speckmanj/ve_emc_pipeline/cad/out/markers_letter.pdf

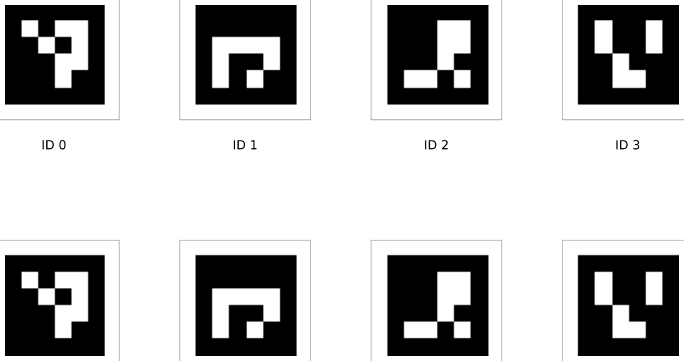
[picture p1: figure]

ID 0 | ID 1 | ID 2 | ID 3

50 mm: measure this before cutting (print at 100%)

Valence EMC scanner plate markers - ArUco 4x4, IDs 0-3. Cut on the gray line. Glue-stick into the pockets: ID 0 front-left (1 dimple), ID 1 front-right (2),
ID 2 back-right (3), ID 3 back-left (4). Label rotation does not matter.
