speckmanj/ve_emc_pipeline/cad/out/markers_letter.png

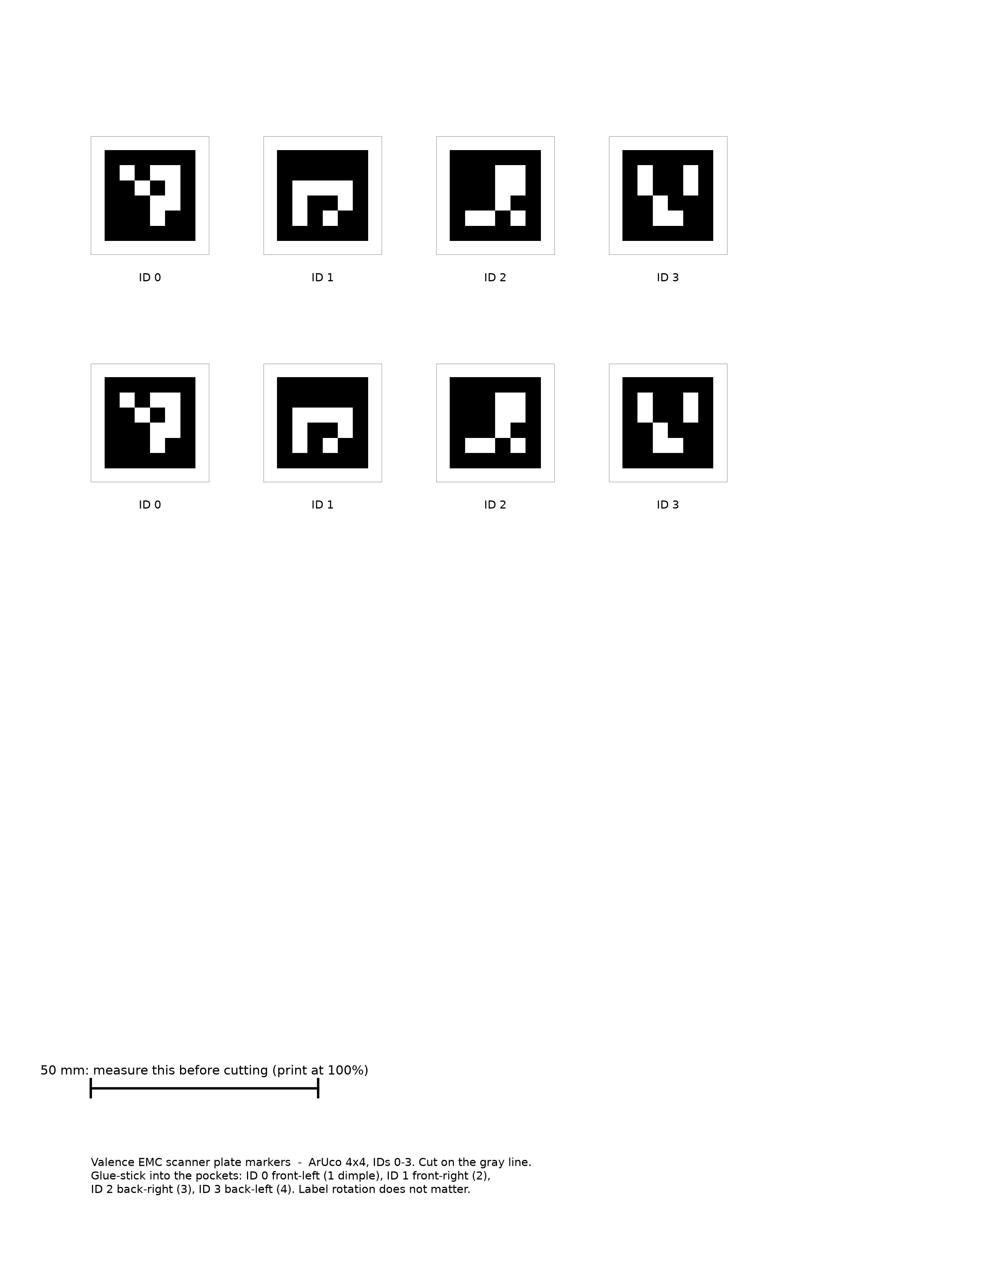
cad/out/markers_letter.png
