speckmanj/ve_emc_pipeline/cad/out/spacer_plate.stl

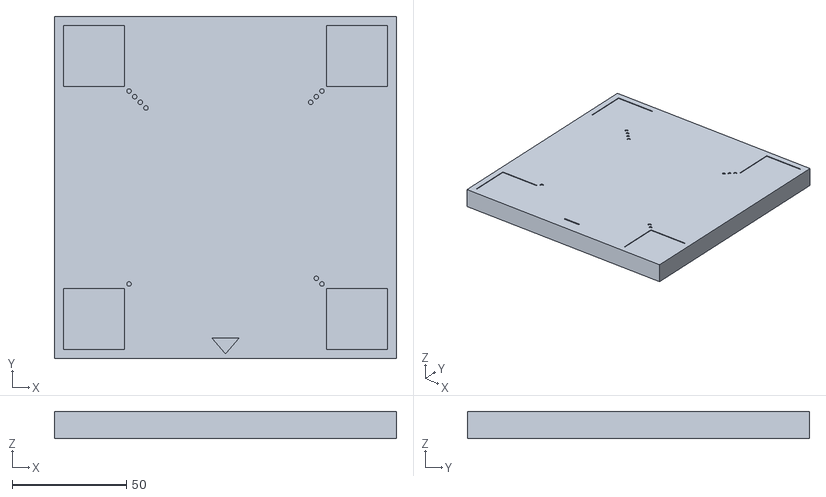
[picture p3: CAD file, 2026-11-12]
cad/out/spacer_plate.stl
150.0 x 150.0 x 12.0
