speckmanj/ve_emc_pipeline/cad/out/probe_mount_y.stl

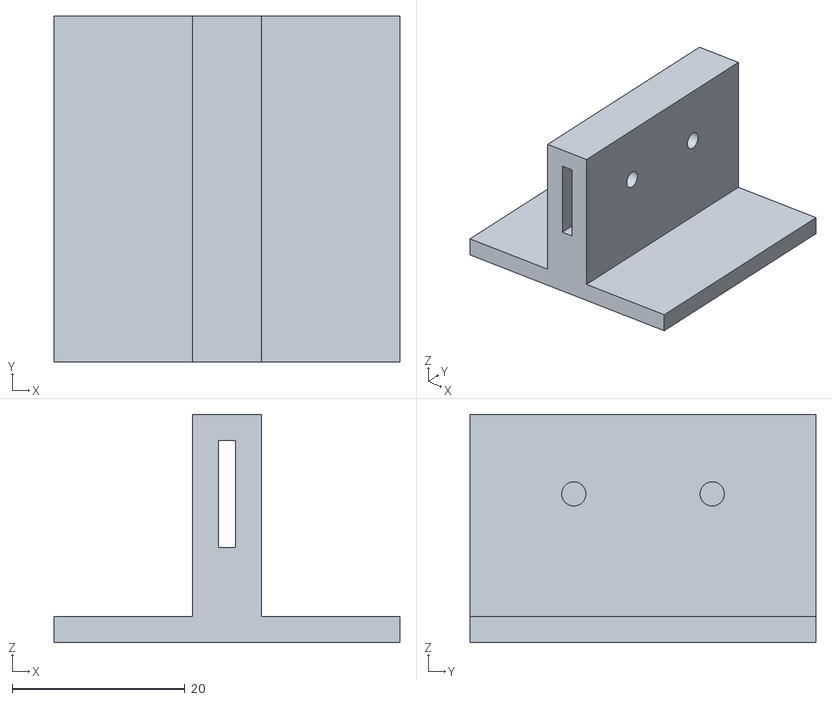
[picture p4: CAD file, 2026-11-12]
cad/out/probe_mount_y.stl
40.0 x 40.0 x 26.4
