speckmanj/ve_emc_pipeline/cad/out/probe_mount_x.stl

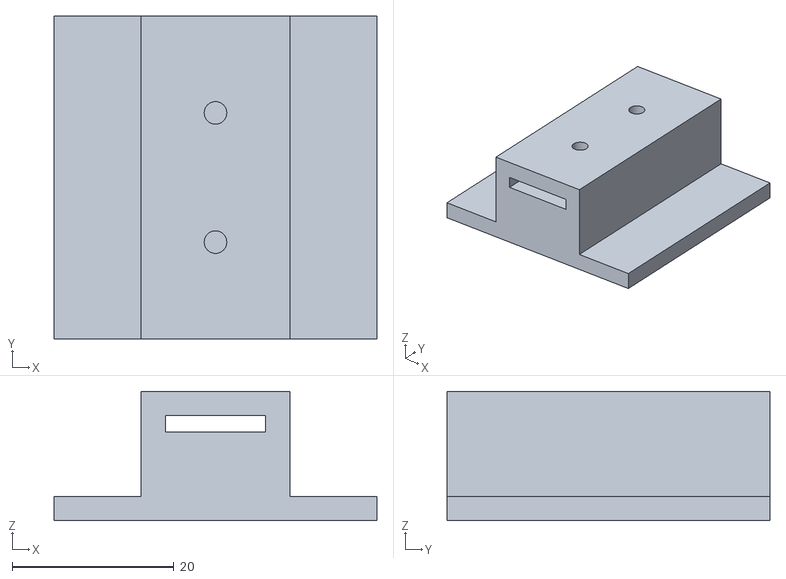
[picture p5: CAD file, 2026-11-12]
cad/out/probe_mount_x.stl
40.0 x 40.0 x 16.0
