speckmanj/ve_emc_pipeline/cad/out/probe_gauge.stl

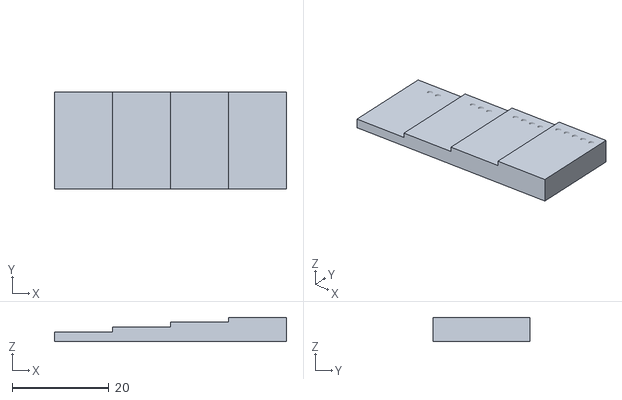
[picture p6: CAD file, 2026-11-12]
cad/out/probe_gauge.stl
48.0 x 20.0 x 5.00
