speckmanj/ve_emc_pipeline/(commit log)

2026-11-12 emcscan v0.1: near-field EMC scanner pipeline
    Printer drivers (Bambu MQTT, serial G-code, Moonraker, sim), TinySA Ultra driver,
    safety-checked raster plan, resumable scan loop, live pyvista viewer, ArUco photo
    registration, heat map report, before/after compare, STL parts and marker sheet,
    docs and a 7-check self-test.
    [probe_gauge.stl, probe_mount_x.stl, probe_mount_y.stl, spacer_plate.stl]
2026-11-13 TinySA driver fixes from the first live bench test
    Tested 2026-11-12 on a tinySA Ultra+ ZS407 (fw v1.4-200) with an LPDA.
    - Retry a sweep once when the reply is short (seen once in ~40 sweeps:
    446 of 450 points right after a setting change); clear error if it
    happens twice.
    - Split the 300-1000 MHz band at 800 MHz (300-800, 800-1000) since the
    Ultra noise floor steps down ~8 dB there; warn if a band straddles it.
    - close() hands the unit back at power-on defaults (LNA off, RBW auto,
    resume); the firmware cannot report the LNA state to restore it.
    - Keep only the firmware line as the version; HW line shown in info().
    - Self-test covers two-line version, retry, double failure, close,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
    [analyzers.py, config.py]
2026-11-13 TinySA: read the firmware's -100 dBm digit overflow
    Live re-test 2026-11-13 (Ultra+ ZS407, fw v1.4-200) showed the short
    sweeps were not lost points: the firmware prints exactly -100 dBm as
    "-:.000000e+01" (":" = digit 10) and the parser dropped those lines.
    The retry from 1afe2a7 could not help (12 of 14 short sweeps failed
    twice in an 80-sweep stress run at RBW 100 kHz).
    - parse_number() reads ":" as a digit worth 10 at its place.
    - Unreadable lines are reported in the error if a sweep is still short.
    - Self-test covers the overflow form and junk input.
    - Removed the temporary live stress script.
    After the fix: 80/80 sweeps OK, 0 retries, 24 points at -100 dBm read
    correctly. close(), ve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
    [analyzers.py]
